lf-lang/interpret/(threads)

Thread 1 (2022-12-16):

Create a serial bootloader

erlingrj, 2022-12-16:
Problems associated with it
- [x] Add UART device and test it
- [ ] How much space does the bootloader need?
- [ ] Create bootloader.c which reads from serial and writes the incoming data starting from the APP_START address
- [ ] Thus we need to build to separate applications:
1. The bootloader
2. The application

They need different startup.c (e.g. btl_startup.c?) btl doesn't need tinyalloc, and should have more or less no dependencies
- [ ] Define a protocol around reading in the app, could be:
START_BYTE LEN1 LEN2 LEN3 LEN4 HEADER_CHECKSUM [DATA] DATA_CHECKSUM
This way we can hopefully detect if there is some noise or similar making the UART connection lossy.

In this approach we don't bother with a linker script telling the compiler where to put the application. We just stream in the application file directly. Other bootloaders use elf-files where you have pairs of <Addr, data>, it is more efficient since you don't have to program all the 0s also. In a simple flexpret program 300 of 1300 instructions were 0x000000...

Closed 2022-12-21.

Thread 4 (2022-12-20):

Make building verilator with trace conditional

erlingrj, 2022-12-20:
We need a simple way to disable vcd tracing. For long programs, such as bootloading over serial it is too slow and the VCD dump gets too big to be usable.

erlingrj, 2022-12-21:
Current work-around:
`make emulator TRACE=0` builds it with tracing disabled. It does require recompilation to turn on/off. Default is tracing on

Closed 2022-12-23.

Thread 7 (2022-12-21):

Think about how to start/terminate programs when running on the FPGA

erlingrj, 2022-12-21:
When the InterPRET is on the FPGA we should try to avoid that the system enters a un-recoverable state. That would mean reprogramming it with a fresh bitstream. To do that I propose:

1. Upon boot, the InterPRET prints a specific byte to serial and then waits for a command.
2. The command can be either: A) Jump to application (to address 0x1000) B) load new application over serial
3. Upon termination or any fault. Print something and then jump back to start.

Observations
- Each time we press the reset button on the FPGA I believe we will lose the bitstream. But it is of course very fast to just reprogram the FPGA.
- We cannot overwrite the currently executing application asynchronously. We need the CPU to return to 0x00 and start executing the bootloader. Thats why we should strive to return to 0x00 in case of fault or termination
- If our program has an infinite while loop, then it seems as if we must reflash the bitstream to get it back to 0x00.

Closed 2023-01-30.

Thread 8 (2022-12-23):

No implemenation of timing instructions

erlingrj, 2022-12-23:
@lsk567, I cannot see any macros or similar implementing the timing instructions of FlexPRET. Do you know where they are, and why it was removed? I am thinking on wait until and interrupt expire. I think for now I only need wait until/

lsk567, 2023-01-09:
Sorry, I missed the notification of this issue until you closed it just now...

erlingrj, 2023-01-09:
No problem, we had the discussion on Zulip  instead

Closed 2023-01-08.

Thread 19 (2023-04-25):

CpuInterfaceRV is stateful

petervdonovan, 2023-04-25:
Comment lifted from discussion in the pret-noc paper:
> Currently I believe that ``blocking'' means that the hardware
continues as usual, except for the fact that future usages of the NoC will
silently fail because the NoC is stuck in this ``blocking'' state. Why do we do
this?

The blocking state seems useless to me. I am not sure about the other states, but if we could get rid of them then that could make concurrent accesses to the NoC by different threads on the same core less complicated.

erlingrj, 2023-05-12:
Could you elaborate a little, Peter? Are you referring to that the sending FIFO could be full?

petervdonovan, 2023-05-16:
Well, there are a few slightly different issues that are all related to the stateful behavior of the CPU interface.

For reference, this is an example of the use case that I have in mind (copied from [here](https://github.com/petervdonovan/cs267-final-project/blob/main/flexpret/idot/test/14.rvg)):
```
[def (do-send)
  {
    [def (others) [memregion t0 t1 noc-base-address words 2 to 16 by 1]]
    [def (scattering) [cyclify a0 a1 others times 5]]
    [def (zipped) [zip
      t4 of [rng-seeded t2 t3 bits 5 length 16 seeded 7]
      and t6 of scattering]]
    [[nonzero-team pariterate-at-rate] {rand,addr} of zipped doing 4 per 42 cycles
      {
        sw [fst rand,addr] [snd rand,addr]
      }]
  }]
```

The idea here is that in order to fully utilize the available TDM slots when performing a scatter operation, we might want to send to all the cores all at once.

In detail, this code zips together a stream of repeating MMIO addresses with a stream of random numbers. All 8 threads on the sending core concurrently iterate over different parts of this zipped stream so that they can write the random numbers to the addresses. Each thread only does 4 iterations every 42 thread cycles, so this doesn't really maximize the utilization of the TDM slots, but if the number of cores were greater, or if the number of threads were smaller, or if the source of numbers were something faster than an RNG, such as just copying an array, then this method of writing to all the other cores (or in this case, cores 2 to 16) at once would be necessary to use the resource efficiently.

For this to work and be efficient, we would need to have the MMIO address specify the destination core instead of specifying the destination core in a separate write. More generally, we would not want the interface to be a state machine because then the different threads which are trying to send messages to different destination cores will interfere with each other. Having the address and data both in one store instruction makes sending a word on the NoC an atomic operation.

We can also reduce interference between different threads sending to different destination cores by removing the FIFO, which has "entries" containing both data and a destination core, and just writing directly to the split buffers. The problem with the FIFO is that because it imposes an order on the words that can be sent, it is a source of timing interference between send operations performed by different threads that have different destination cores. If the entry at the end of the FIFO is waiting for its TDM slot, then the whole FIFO has to wait, even as the other TDM slots may be coming and going.

I have already prototyped an implementation of these ideas that works with 16 cores. I can prepare PRs if we agree that this is wise.

schoeberl, 2023-05-16:
Fully agree. I had this idea also in my mind to have the destination address as part of the write address. This would make the send operation an atomic operation. We can do this.

On the interference between different destinations on a single FIFO, I've added a split FIFO to the NI to avoid head-of-light blocking. This should be the default configuration. I would really like to have this in here and was fighting about 2 hours today with PGP signing and uploading to Maven, but did not succeed. Maybe see the actual source of S4NOC for the NI changes. I have also a paper submitted to DSD that I can share.

Cheers,
Martin

petervdonovan, 2023-05-17:
> I've added a split FIFO to the NI to avoid head-of-light blocking.

If the split FIFOs never fill up, then the single FIFO that comes before the split FIFOs will not do anything, and if they do fill up, then we will have same timing interference that I mentioned, right? I am concerned that the only case in which the single FIFO is useful is the case when something has already gone wrong.

schoeberl, 2023-05-17:
I think the split FIFOs are basically needed to avoid the so called head-of-line blocking - when one packet cannot get out in time as another is sitting in front for a later slot. Therefore, these split FIFOs need only be shallow. For equal traffic just a single word for one TDM round. However, this all depends on the traffic pattern. One can make up traffic patterns where there are more packets at one channel then another.

petervdonovan, 2023-05-17:
> I think the split FIFOs are basically needed to avoid the so called head-of-line blocking - when one packet cannot get out in time as another is sitting in front for a later slot. Therefore, these split FIFOs need only be shallow. For equal traffic just a single word for one TDM round. However, this all depends on the traffic pattern. One can make up traffic patterns where there are more packets at one channel then another.

I agree with all of this, but I do not see how it answers my question.

I guess one answer would be that we want to support both the use case where we are scattering to multiple destination cores, and the use case where we are sending to just one. The split FIFOs are good for the former of these, and the combined FIFO is good for the latter, so the hybrid approach covers both use cases.

But we can think about how important the latter use case is. If we believe that data must be consumed at exactly the same rate as it is produced, then the latter use case is not important. It only helps when we want to be able to send a message of length greater than one word but less than or equal to the capacity of the FIFO, which allows for asynchrony between the sender and receiver, which might turn out to be really useful. I'm not sure.

Thread 21 (2023-05-30):

Verilator issue

schoeberl, 2023-05-30:
Before digging into this, maybe someone has seen this before when trying to build InterPRET:

```
(cd emulator && verilator --cc Top.sim.v --timescale 1ns/1ns --exe --build main.cpp uartsim.cpp)
%Error: Verilator internal fault, sorry. Suggest trying --debug --gdbbt
%Error: Command Failed /opt/homebrew/Cellar/verilator/5.004/bin/verilator_bin --cc Top.sim.v --timescale 1ns/1ns --exe --build main.cpp uartsim.cpp
make: *** [emulator/fp-emu] Error 255
```
