lf-lang/interpret/emulator/uartsim.cpp

#include <stdio.h>
#include <fstream>
#include <stdlib.h>

#include "uartsim.h"


using namespace std;

#define DBG
#ifdef DBG
#define DBG_PRINT(x) do {printf(x); printf("\n");} while(false)
#else
#define DBG_PRINT(x) do {} while(false)
#endif

typedef enum {
    UART_RX_INACTIVE = 0,
    UART_RX_IDLE,
    UART_RX,
    UART_RX_DONE
} uart_rx_state_t;

typedef enum {
    UART_TX_START = 0,
    UART_TX,
    UART_TX_STOP,
    UART_TX_DONE,
    UART_TX_GET_NEW_BYTE
} uart_tx_state_t;

// Hard-coded to 50 MHz clock and 115200
// FIXME: Calculate ticks_per_bit
int ticks_per_bit=434;


int rx_tick_count=0;
int rx_bit_count=0;
unsigned char rx=0;
uart_rx_state_t rx_state;

int tx_tick_count=ticks_per_bit;
int tx_bit_count=0;
int tx_write_idx=0;
uart_tx_state_t tx_state;


fstream app_file;   
void uartsim_init(const char * app_mem_file) {

    rx_state = UART_RX_INACTIVE;
    if (app_mem_file != "") {
        DBG_PRINT("Opening file");
        app_file.open(app_mem_file, ios::in | ios::binary);
        tx_state = UART_TX_GET_NEW_BYTE;
    } else {
        tx_state = UART_TX_DONE;

    }
}


// A simple UART receiver which prints out the received data to the terminal
static int read_pin(int* port, int pin) {
    int res = (*port) & (1 << pin);
    return res;
}

void uartsim_print_rx(int* port, int pin) {
    
    if (rx_state == UART_RX_INACTIVE) {
        if (read_pin(port, pin) == 1) {
            rx_state = UART_RX_IDLE;
        }
    } else if (rx_state == UART_RX_IDLE) {
        if (read_pin(port, pin) == 0) {
            rx_state = UART_RX;
            rx_bit_count = 0;
            rx_tick_count = ticks_per_bit + ticks_per_bit/2;
            rx=0;
        }
    } else if (rx_state == UART_RX) {
        if (--rx_tick_count == 0) {
            // Sample
            rx = rx | (read_pin(port, pin) << rx_bit_count);
            
            rx_bit_count++;
            rx_tick_count = ticks_per_bit;

            if (rx_bit_count == 8) {
                rx_bit_count=0;
                rx_state = UART_RX_DONE;
                rx_tick_count = ticks_per_bit;
            }
        }
    } else if(rx_state == UART_RX_DONE) {
        if (--rx_tick_count == 0) {
            printf("%c", (char) rx);
            fflush(stdout);
            rx_state = UART_RX_IDLE;
        }
    }
}

char tx_byte;
void uartsim_write(unsigned char* tx) {    
    switch(tx_state) {
        case UART_TX_GET_NEW_BYTE: {
            if (!app_file.eof()) {
                app_file.read(&tx_byte,1);
                tx_state = UART_TX_START;
            } else {
                tx_state = UART_TX_DONE;
            }

        }

        case UART_TX_START:
        {
            
            *tx=0;
            if (--tx_tick_count == 0) {
                tx_state = UART_TX;
                tx_tick_count = ticks_per_bit;
                tx_bit_count = 0;
            }
            break;
        }
        case UART_TX:
        {
            *tx = (tx_byte >> tx_bit_count) & 0x1;
            if (--tx_tick_count == 0) {
                tx_tick_count = ticks_per_bit;
                tx_bit_count++;

                if (tx_bit_count == 8) {
                    tx_state = UART_TX_STOP;
                }
            }
            break;
        }
        case UART_TX_STOP:
        {
            *tx = 1;
            if (--tx_tick_count == 0) {
                tx_tick_count=ticks_per_bit;
                tx_bit_count=0;
                tx_state = UART_TX_GET_NEW_BYTE;
            }
        break;
        }

        case UART_TX_DONE:{
            // Keep line high when done/inactive
            *tx=1;
        }
        break;
    }
}
