lf-lang/interpret/emulator/uartsim.h

#ifndef UARTSIM_H
#define UARTSIM_H

void uartsim_init(const char * app_mem_file);

void uartsim_print_rx(int* port, int pin);

// FIXME: Move to same (port,pin) API here also
void uartsim_write(unsigned char* tx);

#endif
