lf-lang/interpret/(commit log)

2022-12-16 Added a WB Uart device and a UART emulator in Verilator printing out anything core0 writes to uart
2022-12-16 Add Uart TX emulator in Verilator and test program.
2022-12-16 Change clock frequency for the FPGA board
2022-12-23 Currently max 4 cores
2023-01-06 Make simple SW UART and wire out GPIO of core0
2023-01-06 Update README with sw-uart info
2023-01-12 Add FPGA synthesis stuff and fix bootloader compilation
    [bootloader.c]
2023-01-12 fix to the threads termination problem
2023-01-13 Add blocking uart rx
2023-01-18 update with the latest thread libraray from flexpret repo
2023-01-18 update hello_noc to not call thread_cancel() after the library update.
2023-01-26 Work on linker/memory issues from MT changes
    [bootloader.c]
2023-01-27 Bump FP, fix bootloader bugs. Add bootloader test
    [hello.c]
2023-01-27 Add constraints file and zed top. Make GPIO ports 8 wide and connect LEDs, SWs, BTNs and PMOD
2023-01-28 Fix Zedboard build scripts
    [zedboardTop.v]
2023-01-30 Start implementing printf
2023-01-30 Stick to 4 threads flex=false in CI
2023-01-30 Connect Verilator printing to SW-uart pin
2023-01-31 Bump FP. Update GPIO driver. Update linker scripts
2023-02-02 Add print and multithreaded example. Move around with sizes
2023-02-06 Update verilator uartsim
2023-02-06 Use print_str API in print example
2023-02-07 Add asynchronous ping pong (2 verions) and asynchronous send receive + Update current noc/ and benchmarks/noc-mt/ programs to use the updated noc routines. There are non deterministic errors though...
2023-02-08 Fix problems with memory areas and stack regions for different threads. Also fix bootloader linker script
    [bootloader.c, print.c, print_hello.c]
2023-02-09 Update usage of printer API
